PaperPit/DIY-EEG-OpenMind/firmware/selftest/README.md

# Самотест ADS1299

Проверяет собранную плату изнутри: подлинность чипа (ID 0x3E), чтение и запись регистров по SPI, DRDY 250 Гц, напряжение DVDD изнутри (каналы 3 и 4 в режиме MVDD, около 3,3 В), температуру, тестовый сигнал, внутренний шум и путь сигнала через каждый вход. Подробное описание каждой строки вывода и что делать при FAIL в [части 2 инструкции](../../docs/02-tests-3d.html), шаги 6–11.

Это готовый проект PlatformIO. Скачивать репозиторий автора и подменять `main.cpp` не нужно. Библиотека ADS1299 лежит в `lib/ADS1299/` (исходный код Xavier Asghar / Conor Russomanno, GPL v3). В этой копии `RREG` и `WREG` ничего не печатают в монитор порта: у автора каждая запись регистра добавляла строку и забивала результат самотеста.

Прошивка собирается под ESP32-S3-WROOM-1-N16R8: 16 МБ flash и 8 МБ octal PSRAM. На собранной плате она ещё не запускалась, поэтому эталонного лога монитора порта здесь нет. Пример удачного вывода показан в части 2 инструкции.

## Как прошить

1. Установите VS Code и расширение PlatformIO.
2. Откройте папку `firmware/selftest` и дождитесь, пока PlatformIO всё настроит.
3. Подключите плату по USB. SW1 в положение USB. Электроды **не** подключены.
4. Если порт не появился или загрузка не начинается: держите SW3 (BOOT), нажмите и отпустите SW2 (RESET), отпустите SW3.
5. Нажмите Upload. После загрузки нажмите SW2 (RESET).
6. Откройте Serial Monitor, скорость 115200.

Из командной строки, находясь в этой папке: `pio run -t upload` и `pio device monitor`.

## Команды в мониторе порта

- `t` повторить все тесты
- `m` живой монитор: размах сигнала по каналам и биты обрыва электродов

Перед тестом «Input path» соедините все 16 штырьков каналов (1+…8+, 1−…8−) с контактом GND на J3A.

После проверки прошейте рабочую прошивку автора и задайте `BIAS_SENSP` под свои каналы (шаг 12 части 2).
