PaperPit/DIY-EEG-OpenMind/hardware/INPUT-RESISTORS.md

# Входные резисторы R10–R27: шум и безопасность

На плате стоят **2,2 кОм** (0603, тонкая плёнка, 0,1 %), как у автора Low-Cost-EEG. Это выбор на минимальный шум. Ниже расчёт, чтобы каждый мог решить сам, нужен ли ему дополнительный резистор в проводе.

## Что даёт каждый вариант

Тепловой шум резистора равен √(4kTRB). Считаем полосу ЭЭГ 1–40 Гц при 300 K и учитываем два пути: резистор канала и резистор REF.

| Вариант | Шум резисторов, мкВ rms | Ток в электрод при пробое 5 В |
|---|---:|---:|
| 2,2 кОм на плате (по умолчанию) | ≈0,05 | ≈2,3 мА |
| 2,2 кОм на плате + 100 кОм в проводе | ≈0,36 | ≈49 мкА |
| 100 кОм на плате + 100 кОм в проводе | ≈0,5 | ≈25 мкА |

Для сравнения: собственный шум ADS1299 при усилении 24 и 250 Гц около 0,14 мкВ rms по datasheet, шум мокрого электрода на коже обычно 1 мкВ и больше, альфа-ритм 10–50 мкВ.

## Почему 2,2 кОм

- Шум резисторов примерно в 3 раза меньше шума самого АЦП, то есть его практически не видно.
- Ток проверки контакта 24 нА даёт на 2,2 кОм всего около 53 мкВ постоянного смещения, это ничтожно.
- Утечка ESD-диодов D1–D5 и разброс конденсаторов C15–C31 на маленьком сопротивлении почти не превращают сетевые 50 Гц в помеху.

## Чем за это платим

2,2 кОм почти не ограничивает ток. Если внутри платы что-то замкнёт питание ±2,5 В или 3,3 В на вход, через электрод может пойти единицы миллиампер. Для приборов, подключаемых к человеку, норма тока при единичной неисправности около 50 мкА. С одним резистором 2,2 кОм её нет.

Поэтому безопасность в этом варианте держится на питании, а не на резисторе:

1. Электроды на голове только при питании от аккумулятора, плата не подключена к USB компьютера, данные идут по Bluetooth.
2. Если нужен USB во время записи, только через изолятор ADuM3160/ADuM4160.
3. Ни одна цепь платы не должна иметь связи с сетью 220 В, даже через зарядку ноутбука.

Внутри платы только 3,7–5 В, и при питании от LiPo пути на сетевую землю нет.

## Дополнительная защита по желанию

Если хотите уложиться в 50 мкА при неисправности, поставьте резистор 100 кОм 0603 в разрыв каждого провода: К1–К8, REF и BIAS, всего 10 штук. Шум вырастет примерно до 0,36 мкВ rms. Это всё ещё меньше шума контакта, но уже больше шума АЦП. Номинал проводных резисторов должен быть одинаковым во всех 10 проводах.

## Что важно при любом варианте

- C15–C31 только C0G/NP0, лучше с допуском 1–2 %. Разброс ёмкостей вместе с разбросом импедансов электродов превращает синфазные 50 Гц в дифференциальную помеху.
- Все 18 резисторов R10–R27 одного номинала и из одной партии.
- Корпус 0603 и изолятор ADuM не защищают от сети и дефибриллятора. Это не медицинское изделие.
