PaperPit/DIY-EEG-OpenMind/SAFETY.md

# Безопасность

Народное ЭЭГ не является медицинским изделием. Не используйте его для диагностики и лечения.

1. **Электроды на голове только при питании от аккумулятора** или через USB-изолятор (ADuM3160/ADuM4160). Ноутбук, подключённый к сети, во время записи лучше тоже отключить от зарядки. Входные резисторы на плате 2,2 кОм выбраны ради минимального шума и сами ток при неисправности почти не ограничивают (около 2 мА при 5 В). Поэтому питание от аккумулятора здесь обязательно. Для дополнительной защиты можно поставить резистор 100 кОм в каждый провод электрода, включая REF и BIAS: ток при пробое станет около 50 мкА, шум вырастет с 0,05 до 0,36 мкВ rms. Подробно в [hardware/INPUT-RESISTORS.md](hardware/INPUT-RESISTORS.md). Корпус 0603 и изолятор ADuM не защищают от сети и дефибриллятора.
2. **Аккумулятор LiPo только через модуль TP4056 с защитой.** Аккумулятор на выводы B+/B−, плата на OUT+/OUT−. Перепутанная полярность сжигает модуль, а аккумулятор может загореться.
3. **Заряжайте при выключенном тумблере и со снятыми электродами,** не на ткани и не без присмотра. Вздувшийся аккумулятор сразу замените.
4. **Не подключайте к этой плате стимуляторы (tDCS/tACS).** Стимулятор делается отдельным устройством со своим аккумулятором и без общей земли.
5. Клей для оргстекла на дихлорэтане используйте только при открытом окне.
