PaperPit/DIY-EEG-OpenMind/enclosure/case-drawings-1to1.pdf

# Корпус из оргстекла 3 мм · раскрой листа 300 × 200 мм

Все размеры в мм. Внутренний объём 131 × 67 × 38, наружный 137 × 73 × 44.
Сборка: дно (A) снизу, продольные стенки (E, F) во всю длину стоят на дне, торцевые (B, C) вклеиваются между ними.
Крышка (D) кладётся сверху на 4 бобышки из склеенных пар квадратов (G) и крепится саморезами 2,9 × 9,5. Для лазерной резки отдайте файл «Корпус оргстекло 3мм - раскрой.dxf» (слой CUT — резка, слой LABELS — не резать).
Ручная резка: резак для пластика по линейке, 5–8 проходов, затем отломить по краю стола. Отверстия: сверло

### 2 мм, затем

рассверлить до размера на малых оборотах, плёнку не снимать до конца работ. Окна USB: два отверстия 8 мм + надфиль.
Пары деталей с отверстиями (A, D, B, C) распечатайте на следующих страницах в масштабе 100 % и приклейте как шаблон.

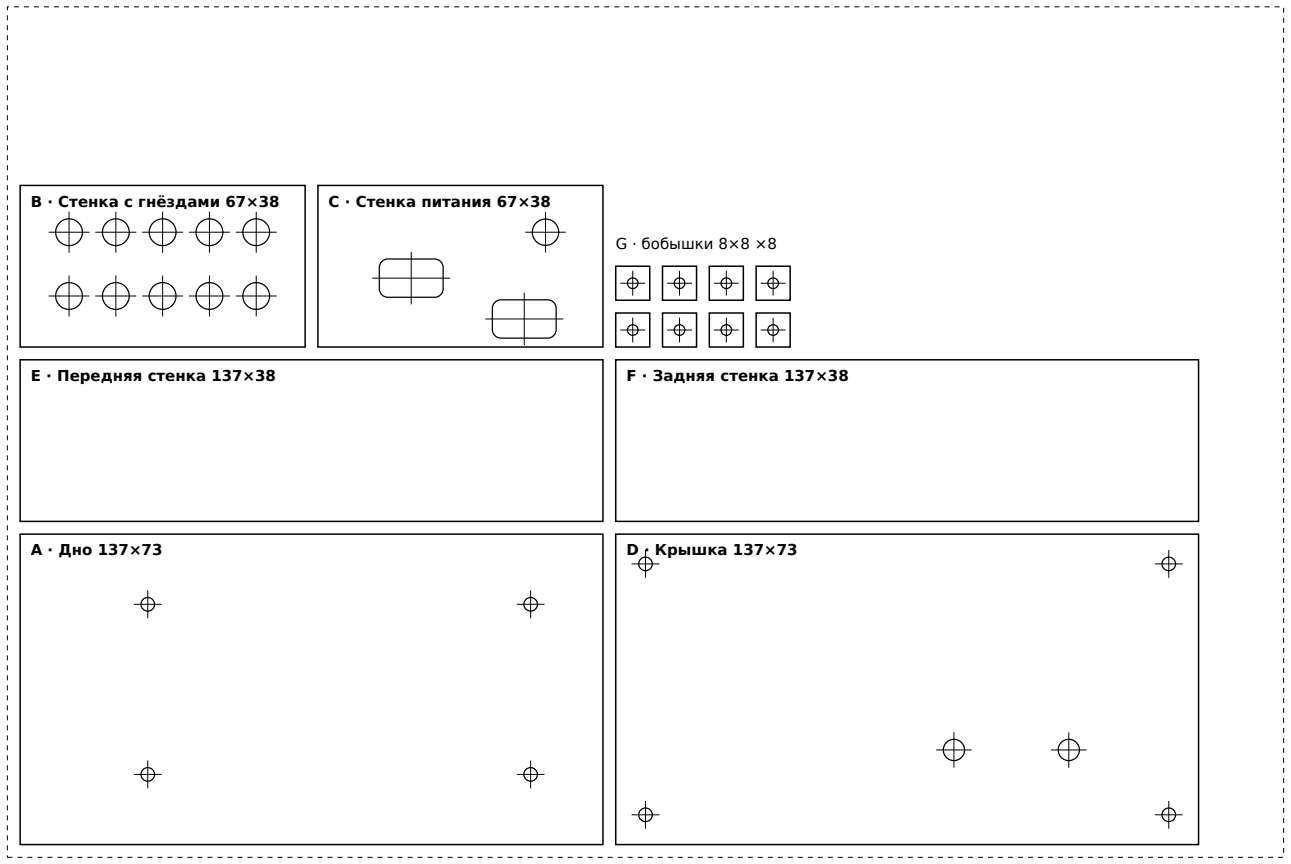
[picture p12: figure]
A · Дно 137×73; · Крышка 137×73; E · Передняя стенка 137×38; F · Задняя стенка 137×38; G · бобышки 8×8 ×8

B · Стенка с гнёздами 67×38 | C · Стенка питания 67×38

Лист 300 × 200 мм, масштаб на этой странице 60 %. Запас между деталями 3 мм на рез.

### Детали

A Дно: 137 × 73
D Крышка: 137 × 73
B Стенка с гнёздами: 67 × 38 C Стенка питания: 67 × 38
E Передняя стенка: 137 × 38 F Задняя стенка: 137 × 38
G Бобышка ×8: 8 × 8 ×8

# Шаблоны 1:1 · дно и крышка (печать 100 %)

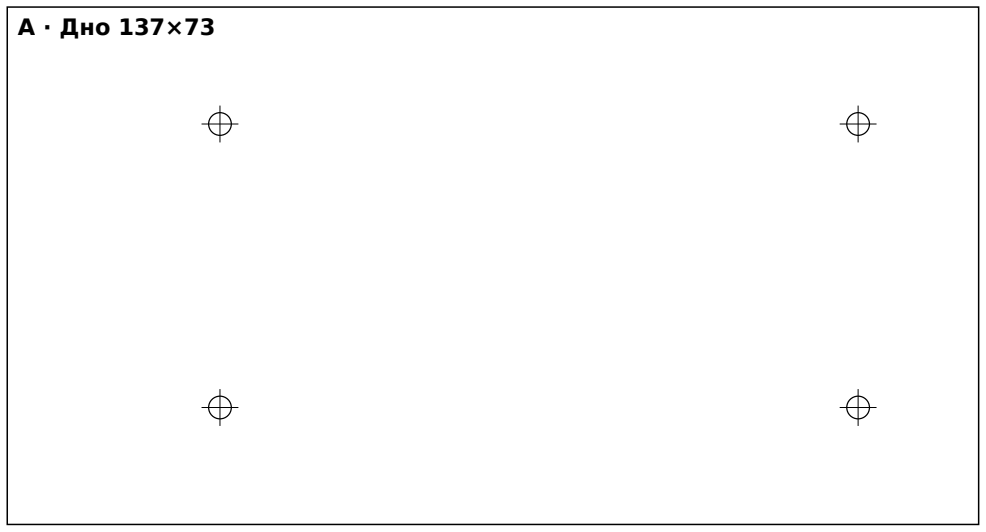
[picture p13: figure]
A · Дно 137×73

Вид сверху. Низ рисунка = передняя стенка (сторона антенны ESP32). 4 отв. Ø3,2 под стойки M3 платы.

Ø3.2 — центр x 30, y 16.5
Ø3.2 — центр x 120, y 16.5
Ø3.2 — центр x 30, y 56.5
Ø3.2 — центр x 120, y 56.5

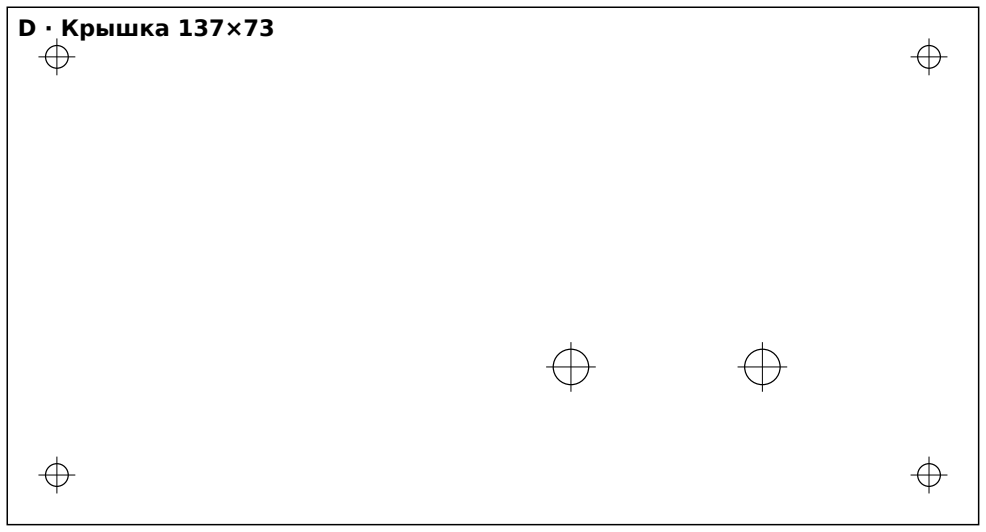
[picture p14: figure]
D · Крышка 137×73

Вид сверху. Углы: Ø3,2 под саморезы в бобышки. Ø5 над кнопками: левое SW3 (BOOT/выход из lead-off), правое SW2 (RESET).

Ø3.2 — центр x 7, y 7
Ø3.2 — центр x 130, y 7
Ø3.2 — центр x 7, y 66
Ø3.2 — центр x 130, y 66
Ø5 — центр x 79.5, y 22.25 Ø5 — центр x 106.5, y 22.25

контроль 50,0 мм — проверьте линейкой

# Шаблоны 1:1 · торцевые стенки, бобышка (печать 100 %)

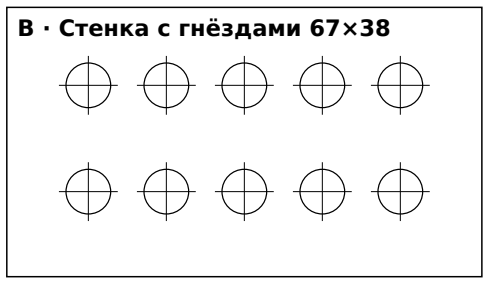
[picture p15: figure]

B · Стенка с гнёздами 67×38 | Вид снаружи. Верхний ряд слева направо: BIAS К7 К5 К3 К1, нижний: К8 К6 К4 К2 REF. Ø6,3 для резьбы M6, уточните по гнезду.
| Ø6.3 — центр x 11.5, y 27 Ø6.3 — центр x 22.5, y 27 Ø6.3 — центр x 33.5, y 27 Ø6.3 — центр x 44.5, y 27 Ø6.3 — центр x 55.5, y 27 Ø6.3 — центр x 11.5, y 12 Ø6.3 — центр x 22.5, y 12 Ø6.3 — центр x 33.5, y 12 Ø6.3 — центр x 44.5, y 12 Ø6.3 — центр x 55.5, y 12

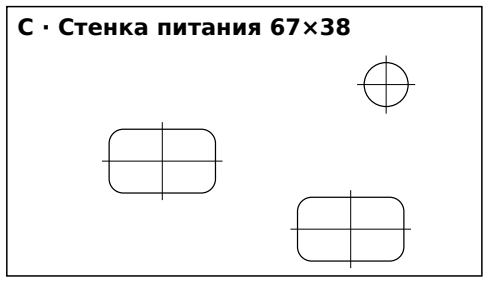
[picture p16: figure]

C · Стенка питания 67×38 | Вид снаружи. Слева вверху окно USB-C платы (данные/прошивка), справа внизу окно USB-C зарядки TP4056, справа вверху Ø6,2 тумблер MTS-102.
| окно 15×9 (R2) — центр x 21.93, y 16.2 окно 15×9 (R2) — центр x 48.5, y 6.6 Ø6.2 — центр x 53.5, y 27

G · Бобышка 8×8, 8 шт.

Склеить попарно (6 мм), 4 штуки в верхние углы под крышку. Отв. Ø2,5 под саморез 2,9.

Ø2.5 — центр x 4, y 4

E и F (137 × 38) без отверстий: просто отрежьте по размеру.

Координаты отверстий: x — от левого края детали, y — от нижнего края, как на рисунке.

контроль 50,0 мм — проверьте линейкой
