PaperPit/DIY-EEG-OpenMind/enclosure/panel-drill-template-1to1.pdf

## Панель электродов Low-Cost-EEG · шаблон сверловки 1:1

Печатать в масштабе 100 % («Фактический размер», без подгонки под страницу).
Проверьте линейкой контрольный отрезок 50,0 мм. Если он не 50 мм, шаблон напечатан неверно.
Перекрестие ЦЕНТР = центр стенки B 67 × 38 мм (корпус из оргстекла). Ряды: 27 и 12 мм от нижнего края стенки. Сверлите сначала 2 мм, затем рассверлите по резьбе EE-B05 (+0,2–0,3 мм к наружному диаметру резьбы).
Вид СНАРУЖИ корпуса. Подписи под отверстиями совпадают с наклейкой на панели.

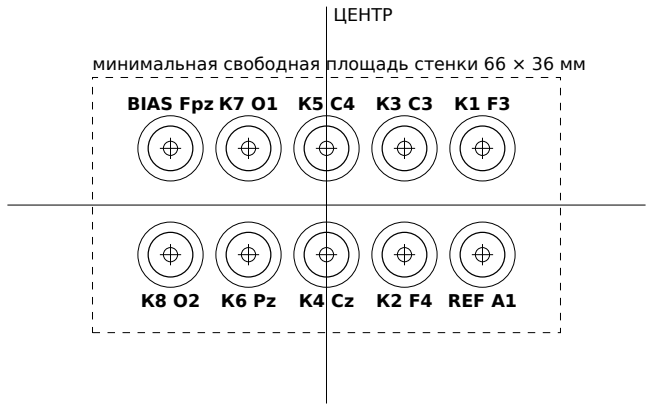
[picture p17: figure]
ЦЕНТР; BIAS Fpz; REF A1

минимальная свободная площадь стенки 66 × 36 мм

Шаг по горизонтали 11,0 мм, между рядами 15,0 мм.
Внутренний круг Ø6,3 мм: отверстие под M6 (уточнить по замеру). Внешний круг Ø9,2 мм: гайка.

контроль 50,0 мм

Разводка (внутри корпуса), провод Dupont на ВЫВОД 1 (внешний ряд, квадратная площадка):

К1→J3I К2→J3H К3→J3G К4→J3F К5→J3E К6→J3D К7→J3C К8→J3B REF→J3J BIAS→J3A

Вывод 2 у J3A = GND (только экран), у J3J = SRB2 (не подключать), у остальных = минус канала (свободен).
