PaperPit/DIY-EEG-OpenMind/docs/img/device-electrodes.jpg

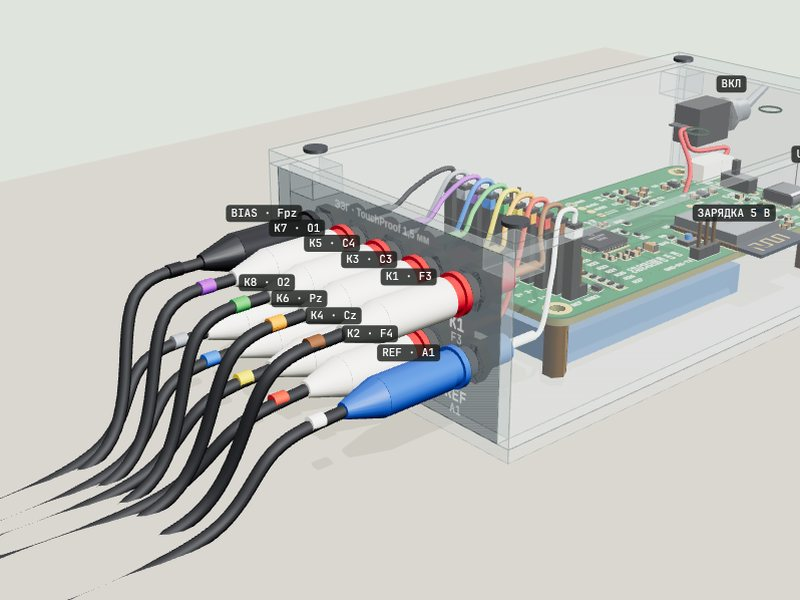
docs/img/device-electrodes.jpg
