PaperPit/DIY-EEG-OpenMind/docs/img/social-preview.jpg

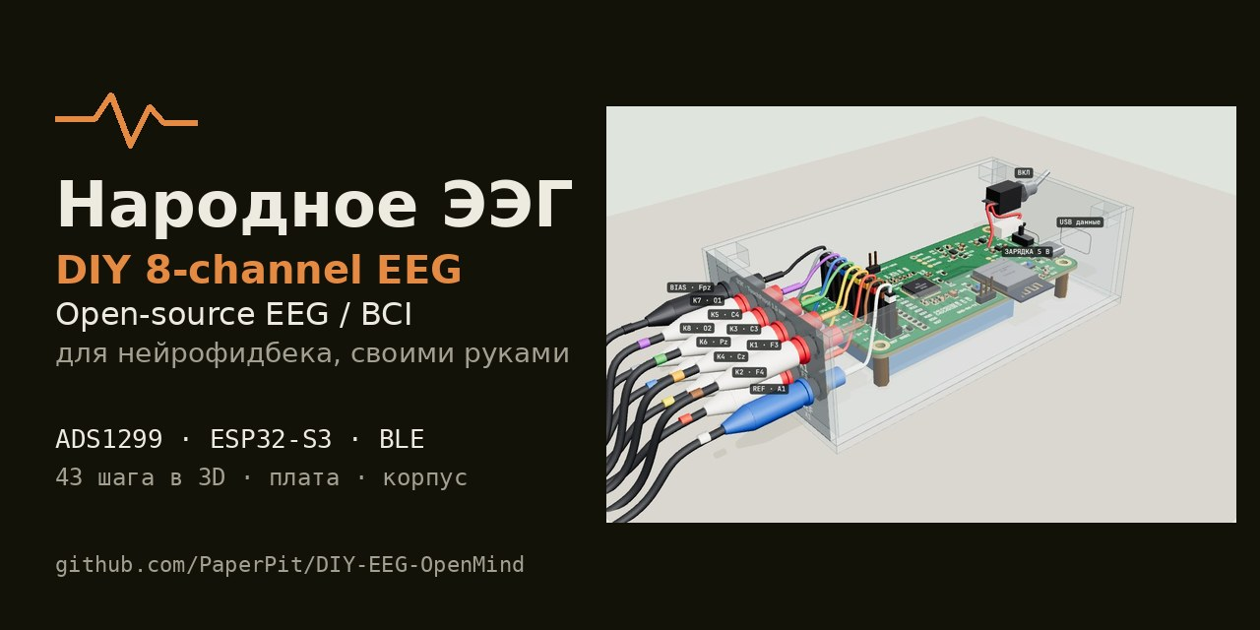
docs/img/social-preview.jpg
