PaperPit/DIY-EEG-OpenMind/hardware/bom.csv

Designator | Qty | Значение | Корпус | Исходный MPN (Mouser) | Что заказать на LCSC | LCSC # | Примечание
U4 | 1 | ADS1299, 8 каналов, 24 бит | TQFP-64 (0,5 мм) | ADS1299IPAGR | ADS1299IPAGR (TI) | C476817 | Главная деталь, ~$62. Брать только у LCSC/Mouser/Чип и Дип, не на AliExpress (риск подделки)
U5 | 1 | Модуль ESP32-S3, 8 МБ flash, 8 МБ PSRAM | WROOM-1 | ESP32-S3-WROOM-1-N8R8 | ESP32-S3-WROOM-1-N16R8 (Espressif) | C2913202 | N8R8 на LCSC нет в наличии (C2913201). N16R8 той же посадки, прошивки автора и Da1412 работают на нём без изменений
U1 | 1 | Charge pump + LDO, ±2,5 В для AVDD/AVSS | WSON-12 | LM27762DSSR | LM27762DSSR (TI) | C473398 | $0,97, в наличии
U2 | 1 | LDO 3,3 В 1 А (ESP32) | SOT-23-5 | TLV75733PDBVR | TLV75733PDBVR (TI) | C485517
U3 | 1 | LDO 3,3 В 300 мА малошумящий (DVDD ADS1299) | SOT-23-5 | TPS7A2033PDBVR | TPS7A2033PDBVR (TI) | C2862740
D1–D5 | 5 | ESD-защита 4 линии, 0,7 пФ | SC-70-6 | TPD4E1B06DCKR | TPD4E1B06DCKR (TI) | C840093 | Защита входов электродов. Не заменять на диоды с большой утечкой
D6 | 1 | TVS 5 В | SOD-323 | SD05T1G | SD05T1G (onsemi) | C233423 | Защита USB
D7 | 1 | TVS 5 В | SOD-523 | ESD5Z5.0T5G | ESD5Z5.0T1G (onsemi) | C82044 | Защита входа батареи
J1 | 1 | JST PH 2 пин, угловой, THT | — | S2B-PH-K-S | S2B-PH-K-S(LF)(SN) или клон | искать по MPN | Разъём аккумулятора. Проверить полярность провода LiPo!
J2 | 1 | USB-C 2.0 гнездо | SMD | 217179-0001 | 217179-0001 (Molex) | C3197684
J3A–J3J, JP1 | 11 | Штырьки 2×1, шаг 2,54 | THT | TSW-102-26-F-S | Любая PLS гребёнка 2,54 мм (отломать) | — | Входы электродов. Удобно взять 40-пин гребёнку
J5 | 1 | Штырьки 3×1, шаг 2,54 | THT | TSW-103-07-T-S | Любая PLS гребёнка 2,54 мм | — | UART
SW1 | 1 | Ползунковый переключатель SPDT | THT | 1101M2S3CQE2 | 1101M2S3CQE2 (C&K) или совместимый по посадке | искать по MPN | Сверить шаг выводов по чертежу перед заменой
SW2, SW3 | 2 | Тактовая кнопка | SMD | 7914J-1-032 | 7914J-1-032 (Bourns) | искать по MPN | BOOT и RESET
TP1 | 1 | Тестовая точка | THT | Keystone 5003 | Keystone 5003 или пропустить | — | Можно не ставить
R10–R27 | 18 | 2,2 кОм 0,1% тонкоплёночный | 0603 | MCT06030D2201BP500 | 2,2 кОм 0603 0,1% (или 1%) | — | 18 штук, как у автора (в описании его BOM ошибочно «100 Ом», по MPN это 2,2 кОм). Минимальный шум, около 0,05 мкВ rms. Резистор 100 кОм в проводе по желанию, см. hardware/INPUT-RESISTORS.md
R1 | 1 | 130 кОм | 0603 | MCT06030D1303BP100 | 130 кОм 0603 1% | — | ВНИМАНИЕ: в описании BOM ошибочно «100 Ом», по MPN и схеме 130 кОм
R9 | 1 | 1 МОм | 0603 | MCT06030C1004FPW00 | 1 МОм 0603 1% | — | ВНИМАНИЕ: в описании BOM ошибочно «100 Ом», по MPN и схеме 1 МОм (цепь BIAS)
R2 | 1 | 120 кОм 0,1% | 0603 | RT0603BRD07120KL | 120 кОм 0603 0,1% | — | Задаёт напряжение LM27762. Точность важна
R3 | 1 | 105 кОм 0,1% | 0603 | RT0603BRD07105KL | 105 кОм 0603 0,1% | — | Задаёт напряжение LM27762. Точность важна
R4 | 1 | 100 кОм 0,1% | 0603 | AT0603BRD07100KL | 100 кОм 0603 0,1% | — | Задаёт напряжение LM27762. Точность важна
R5, R6 | 2 | 5,1 кОм 1% | 0603 | RT0603FRE075K1L | 5,1 кОм 0603 | — | CC-резисторы USB-C
R7, R8, R28–R35 | 10 | 10 кОм 1% | 0603 | AC0603FR-7W10KL | 10 кОм 0603 | —
C15–C31 | 17 | 1 нФ C0G/NP0 1% | 0603 | C0603C102F5GACTU | 1 нФ 0603 C0G (NP0) | — | Входные фильтры. Обязательно C0G/NP0, не X7R
C14 | 1 | 1,5 нФ C0G 100 В | 0603 | GRM1885C2A152JA01D | 1,5 нФ 0603 C0G | — | Цепь BIAS
C1 | 1 | 0,47 мкФ X7R 16 В | 0603 | C0603C474K4RACAUTO | 0,47 мкФ 0603 X7R | —
C10, C11, C35, C36, C38–C40, C43, C44, C46 | 10 | 1 мкФ X7R 16 В | 0603 | CC0603KRX7R7BB105 | 1 мкФ 0603 X7R | —
C13 | 1 | 100 нФ X7R 50 В | 0603 | CGA3E2X7R1H104K080AD | 100 нФ 0603 X7R | —
C32, C37, C41, C42, C45, C47 | 6 | 100 нФ X7R | 0603 | C0603X104J4RACTU | 100 нФ 0603 X7R | —
C2, C3, C48, C49 | 4 | 4,7 мкФ X7R 16 В | 0805 | GCJ21BR71C475KA01K | 4,7 мкФ 0805 X7R | —
C4, C5 | 2 | 2,2 мкФ X7R 16 В | 0805 | GCM21BR71C225KA64K | 2,2 мкФ 0805 X7R | — | Летающие конденсаторы LM27762
C6, C7, C9, C12, C33 | 5 | 10 мкФ X5R 25 В | 0805 | GRJ21BR61E106KE01L | 10 мкФ 0805 X5R 25 В | —
C34 | 1 | 100 мкФ X5R 10 В | 1206 | GRM31CR61A107MEA8L | 100 мкФ 1206 X5R | —
— | 1 | Аккумулятор LiPo 3,7 В 2000 мА·ч с защитой и разъёмом JST PH 2.0 | — | — | AliExpress / Чип и Дип | — | Не входит в BOM автора
— | 1 | Модуль зарядки TP4056 (USB-C) с защитой | — | — | AliExpress / Чип и Дип | — | На плате нет зарядки
