PaperPit/DIY-EEG-OpenMind/hardware/shopping-list.csv

Магазин | Что купить | Корпус | Кол-во купить | Нужно на 1 плату | Ссылка или запрос для поиска | Ориентир цены за всё, ₽ | Примечание
AliExpress (продавец с отзывами) | ADS1299IPAG или ADS1299IPAGR (TI) | TQFP-64 | 1 | 1 | https://aliexpress.ru/wholesale?SearchText=ADS1299IPAG | 3 300–5 300 | Главная деталь. Цены на AliExpress $39–62. Брать у продавца с рейтингом 97%+ и отзывами с фото. После пайки проверить: регистр ID = 0x3E. Бывают подделки и перемаркировка
Чип и Дип (запасной вариант) | ADS1299IPAGR (TI) | TQFP-64 | — | — | https://www.chipdip.ru/product0/8029976658 | 11 080 за шт. | Минимальная партия у них была 6 шт (≈66 тыс ₽). Позвонить или написать менеджеру: иногда продают 1 шт под заказ
Чип и Дип | ESP32-S3-WROOM-1-N16R8 (Espressif) | модуль | 1 | 1 | https://www.chipdip.ru/product/esp32-s3-wroom-1-n16r8-vstraivaemyy-wi-fi-ble5.0-espressif-9001095134 | 700–1 000 | Именно WROOM-1 (антенна на плате), не WROOM-1U. Подходит и N8R8. На AliExpress: https://aliexpress.ru/wholesale?SearchText=ESP32-S3-WROOM-1-N16R8
AliExpress | LM27762DSSR (TI) | WSON-12 | 3 | 1 | https://aliexpress.ru/wholesale?SearchText=LM27762DSSR | 500–800 | Пример лота 5 шт: https://www.aliexpress.us/item/3256807318608101.html. В Чип и Дип тоже есть: https://www.chipdip.ru/product1/8017626869. Замены нет, корпус уникальный
AliExpress | TPS7A2033PDBVR (TI), стабилизатор 3,3 В малошумящий | SOT-23-5 | 5 | 1 | https://aliexpress.ru/wholesale?SearchText=TPS7A2033PDBVR | 300–600 | Если не найдётся: TLV75733PDBVR, у него та же цоколёвка (1 IN, 2 GND, 3 EN, 4 NC, 5 OUT), шум чуть выше. Также искать в Чип и Дип: https://www.chipdip.ru/search?searchtext=TPS7A2033
AliExpress | TLV75733PDBVR (TI), стабилизатор 3,3 В | SOT-23-5 | 10 | 1 | https://aliexpress.ru/wholesale?SearchText=TLV75733PDBVR | 100–150 | Лоты по 10 шт от $1,09. Маркировка на корпусе 1FKF. Не путать с TLV75533 и TLV75733PDRVR (другой корпус)
AliExpress | TPD4E1B06DCKR (TI), защита входов | SC-70-6 (SOT-363) | 10 | 5 | https://aliexpress.ru/wholesale?SearchText=TPD4E1B06DCKR | 300–500 | Лоты по 10 шт $3,7–5,5. Маркировка BY/BYP. Не путать с TPD4E1U06 (BP*), у него другая ёмкость
AliExpress или Чип и Дип | SD05T1G (onsemi) или любой TVS 5 В | SOD-323 | 5 | 1 | https://aliexpress.ru/wholesale?SearchText=SD05T1G%20SOD-323 | 100–200 | Аналог: любой однонаправленный TVS 5 В в SOD-323. Чип и Дип: https://www.chipdip.ru/search?searchtext=SD05%20SOD-323
AliExpress или Чип и Дип | ESD5Z5.0T1G (onsemi) или аналог | SOD-523 | 5 | 1 | https://aliexpress.ru/wholesale?SearchText=ESD5Z5.0T1G | 100–200 | Аналог: любой ESD-диод 5 В в SOD-523. Чип и Дип: https://www.chipdip.ru/search?searchtext=ESD5Z5.0
Чип и Дип или AliExpress | USB-C гнездо Molex 217179-0001, 16 контактов | SMD + выводы корпуса | 2 | 1 | https://www.chipdip.ru/search?searchtext=217179-0001 ; https://aliexpress.ru/wholesale?SearchText=217179-0001%20USB%20C | 200–600 | Замена: HRO TYPE-C-31-M-12 (верхний монтаж, 16 контактов, 4 вывода корпуса в пазы ~8,6 мм поперёк, ~4 мм вдоль). Врезные (mid-mount) с плоскими лапками НЕ подходят
Чип и Дип или AliExpress | Гнездо JST PH 2 контакта, угловое, S2B-PH-K-S | THT, шаг 2,0 | 2 | 1 | https://www.chipdip.ru/product1/8002985838 | 30–60 | Разъём аккумулятора. На AliExpress «PH2.0 2P угловой» тоже подходит
Чип и Дип или AliExpress | Ползунковый переключатель C&K 1101M2S3CQE2 | THT | 1 | 1 | https://www.chipdip.ru/search?searchtext=1101M2S3CQE2 ; https://aliexpress.ru/wholesale?SearchText=1101M2S3CQE2 | 300–500 | Выключатель питания. Проверенная замена: SS12D10 (G4/G5) с шагом выводов 4,7 мм. На плате 3 отверстия 1,85 мм, шаг 4,7 мм
Чип и Дип или AliExpress | Кнопка Bourns 7914J-1-032 (или 7914J-1-032E) | SMD | 3 | 2 | https://www.chipdip.ru/product0/8007351713 | 150–300 | Аналог: тактовая SMD-кнопка того же размера, сверить по площадкам
AliExpress или Чип и Дип | Штыревая гребёнка PLS 1×40, шаг 2,54 | THT | 2 | — | https://aliexpress.ru/wholesale?SearchText=pin%20header%201x40%202.54 | 50 | Нарезать на 11 штук по 2 и 1 по 3
AliExpress | Набор резисторов 0603 1%, 170 номиналов по 20–50 шт | 0603 | 1 | — | https://aliexpress.ru/wholesale?SearchText=0603%20resistor%20kit%201%25%20170%20values | 400–700 | Закрывает 130 кОм (R1), 1 МОм (R9), 5,1 кОм (R5, R6), 10 кОм (R7, R8, R28–R35)
Чип и Дип | Резистор 2,2 кОм 0,1% 0603 (тонкоплёночный) | 0603 | 20 | 18 | https://www.chipdip.ru/search?searchtext=0603%200.1%25%202.2%20%D0%BA%D0%9E%D0%BC | 300–600 | R10–R27, входные фильтры. 0,1% даёт лучшее совпадение каналов и меньше наводки 50 Гц
Чип и Дип | Резистор 100 кОм 0603 (по желанию, в провода) | 0603 | 12 | 0 | https://www.chipdip.ru/search?searchtext=0603%200.1%25%20100%20%D0%BA%D0%9E%D0%BC | 100–300 | Не обязательно. 10 штук в провода К1–К8, REF и BIAS для защиты: ток при пробое 50 мкА, шум 0,36 мкВ rms. См. hardware/INPUT-RESISTORS.md
Чип и Дип | Резистор 120 кОм 0,1% 0603 (тонкоплёночный) | 0603 | 5 | 1 | https://www.chipdip.ru/search?searchtext=0603%200.1%25%20120%20%D0%BA%D0%9E%D0%BC | 100–200 | R2. Точность 0,1% обязательна
Чип и Дип | Резистор 105 кОм 0,1% 0603 (тонкоплёночный) | 0603 | 5 | 1 | https://www.chipdip.ru/search?searchtext=0603%200.1%25%20105%20%D0%BA%D0%9E%D0%BC | 100–200 | R3. Точность 0,1% обязательна, в наборах такого номинала нет
Чип и Дип | Резистор 100 кОм 0,1% 0603 (тонкоплёночный) | 0603 | 5 | 1 | https://www.chipdip.ru/search?searchtext=0603%200.1%25%20100%20%D0%BA%D0%9E%D0%BC | 100–200 | R4. Точность 0,1% обязательна
Чип и Дип | Конденсатор 1 нФ C0G (NP0) 50 В 0603 | 0603 | 20 | 17 | https://www.chipdip.ru/search?searchtext=1%20%D0%BD%D0%A4%200603%20NP0 | 100–200 | C15–C31. Строго C0G/NP0, допуск 1–2% (буква F или G в маркировке). Из наборов AliExpress не брать: диэлектрик не гарантирован
Чип и Дип | Конденсатор 1,5 нФ C0G (NP0) 0603 | 0603 | 5 | 1 | https://www.chipdip.ru/search?searchtext=1.5%20%D0%BD%D0%A4%200603%20NP0 | 50 | C14. Строго C0G/NP0
AliExpress или Чип и Дип | Конденсатор 100 нФ X7R 50 В 0603 | 0603 | 20 | 7 | https://aliexpress.ru/wholesale?SearchText=0603%20100nF%20X7R%2050V | 50–100 | C13, C32, C37, C41, C42, C45, C47
AliExpress или Чип и Дип | Конденсатор 1 мкФ X7R 16 В 0603 | 0603 | 20 | 10 | https://aliexpress.ru/wholesale?SearchText=0603%201uF%20X7R%2016V | 50–100
AliExpress или Чип и Дип | Конденсатор 0,47 мкФ X7R 16 В 0603 | 0603 | 10 | 1 | https://aliexpress.ru/wholesale?SearchText=0603%20474%20X7R | 50 | C1
Чип и Дип | Конденсатор 2,2 мкФ X7R 16 В 0805 | 0805 | 5 | 2 | https://www.chipdip.ru/search?searchtext=2.2%20%D0%BC%D0%BA%D0%A4%200805%20X7R%2016%20%D0%92 | 50–100 | C4, C5 у LM27762
Чип и Дип | Конденсатор 4,7 мкФ X7R 16 В 0805 | 0805 | 10 | 4 | https://www.chipdip.ru/search?searchtext=4.7%20%D0%BC%D0%BA%D0%A4%200805%20X7R%2016%20%D0%92 | 100
Чип и Дип | Конденсатор 10 мкФ 25 В 0805 (X5R или X7R) | 0805 | 10 | 5 | https://www.chipdip.ru/search?searchtext=10%20%D0%BC%D0%BA%D0%A4%200805%2025%20%D0%92 | 100–150
Чип и Дип | Конденсатор 100 мкФ 10 В 1206 (X5R) | 1206 | 2 | 1 | https://www.chipdip.ru/search?searchtext=100%20%D0%BC%D0%BA%D0%A4%201206%2010%20%D0%92 | 100–200 | C34
AliExpress | USB-изолятор на ADuM3160 (USB 2.0 Full Speed) | модуль | 1 | — | https://aliexpress.ru/wholesale?SearchText=ADuM3160%20USB%20isolator | 1 000–1 500 | Для работы по USB при электродах на голове: развязывает человека от компьютера и сети
Ozon или AliExpress | Аккумулятор LiPo 3,7 В 2000 мА·ч с платой защиты и разъёмом JST PH 2.0 | — | 1 | 1 | https://www.ozon.ru/search/ | 500–800 | Перед подключением проверить полярность: красный провод на + у J1
Ozon или AliExpress | Модуль зарядки TP4056 USB-C с защитой | — | 2 | 1 | https://www.ozon.ru/search/ | 150–250 | Заряжать отдельно, на плате зарядки нет
AliExpress или Ozon | Золочёные чашечные ЭЭГ-электроды, набор 10 шт | — | 1 | 1 | https://aliexpress.ru/wholesale?SearchText=EEG%20gold%20cup%20electrode | 1 500–2 500 | 8 каналов + REF + BIAS
AliExpress | Ушные клипсы-электроды | — | 2 | 2 | https://aliexpress.ru/wholesale?SearchText=EEG%20ear%20clip%20electrode | 300–500 | Референс и BIAS на мочки ушей
Ozon или AliExpress | Перемычки Dupont мама–мама 20 см | — | 1 | 1 | https://www.ozon.ru/search/ | 150–250 | Подключение электродов к гребёнкам
Ozon или AliExpress | Электропроводная паста для ЭЭГ (Ten20 или аналог) | — | 1 | 1 | https://www.ozon.ru/search/ | 800–1 500
Ozon или AliExpress | Эластичная шапочка или повязка для электродов | — | 1 | 1 | https://aliexpress.ru/wholesale?SearchText=EEG%20cap%20headband%20electrode | 500–1 000
Ozon или Чип и Дип | Гелевый флюс RMA-223 или аналог | — | 1 | — | https://www.ozon.ru/search/?text=%D1%84%D0%BB%D1%8E%D1%81%20RMA-223 | 300 | Инструмент, если нет
Ozon или Чип и Дип | Паяльная паста Sn63/Pb37 | — | 1 | — | https://www.ozon.ru/search/ | 400 | Инструмент, если нет
Ozon | Оплётка 2–3 мм, изопропиловый спирт, пинцет | — | 1 | — | https://www.ozon.ru/search/ | 500 | Инструмент, если нет
AliExpress или Ozon | Учебный набор SMD или переходники TQFP64/QFN→DIP | — | 1 | — | https://aliexpress.ru/wholesale?SearchText=TQFP64%20adapter%20board | 250 | Тренировка перед основной платой
