PaperPit/DIY-EEG-OpenMind/enclosure/shopping-list-panel.csv

Магазин | Что купить | Кол-во купить | Нужно | Ссылка или запрос для поиска | Ориентир цены, ₽ | Примечание
Ozon | Оргстекло прозрачное 3 мм, лист не меньше 300 × 200 мм | 1 | 1 | https://www.ozon.ru/search/ | 300–600 | Литое или экструзионное, оба подходят. Либо сразу отдать DXF в мастерскую лазерной резки (обычно 300–800 ₽ за такой лист вместе с материалом)
Ozon / Чип и Дип | Клей для оргстекла (на основе дихлорэтана) со шприцем или иглой | 1 | 1 | https://www.ozon.ru/search/ | 200–400 | Капиллярный: наносится в стык, затекает сам. Клеить при открытом окне
Ozon | Резак для пластика (крючковый нож) | 1 | 1 | https://www.ozon.ru/search/ | 200–400 | Не нужен при лазерной резке
Ozon / Чип и Дип | Саморезы 2,9 × 9,5 с полукруглой головкой | 4 | 4 | https://www.ozon.ru/search/?text=%D1%81%D0%B0%D0%BC%D0%BE%D1%80%D0%B5%D0%B7+2.9x9.5 | 50–100 | Крышка к бобышкам. Можно M3 × 8, если нарезать резьбу метчиком
Чип и Дип | Тумблер MTS-102 (ON-ON, 3 вывода, отв. 6 мм) | 1 | 1 | https://www.chipdip.ru/search?searchtext=MTS-102 | 60–120 | Выключатель питания на стенке C. Используются средний и один крайний вывод
Чип и Дип / AliExpress | Пигтейлы JST PH 2.0, 2 контакта (вилка и розетка на проводах) | 2 пары | 2 | https://aliexpress.ru/wholesale?SearchText=JST%20PH%202.0%202pin%20pigtail%20male%20female | 100–200 | Один под разъём аккумулятора к B+/B−, второй из OUT к J1 платы. Полярность J1: квадратная площадка = минус
Чип и Дип | Провод монтажный силиконовый 22–24 AWG, красный и чёрный | по 0,5 м | ≈ 30 см | https://www.chipdip.ru/search | 60–150 | Питание: TP4056 → тумблер → J1
— | Модуль TP4056 USB-C с защитой и LiPo 2000 мА·ч с JST PH | — | 1 + 1 | — | — | Уже есть в основном списке покупок. Брать модуль именно с защитой: шесть площадок IN, B+, B−, OUT+, OUT−
Ozon / AliExpress | Ножки резиновые самоклеящиеся | 4 | 4 | https://www.ozon.ru/search/ | 50–150 | Чтобы головки винтов на дне не царапали стол
AliExpress | Гнёзда EE-B05 под DIN 42802 1,5 мм (TouchProof), под гайку | 2 лота по 8 шт | 10 | https://aliexpress.ru/wholesale?SearchText=EE-B05%20DIN42802%201.5mm%20socket | 700–1 400 | Тот лот со скриншота. Если можно выбрать цвет: 8 красных + 1 синее (REF) + 1 чёрное (BIAS). Запас на случай сорванной резьбы
Чип и Дип / AliExpress | Провода Dupont «мама–мама» 10 см, шлейф 40 шт | 1 | 10 | https://www.chipdip.ru/search | 100–200 | Стандартный радужный шлейф уже идёт по цветовому коду 1 коричневый … 8 серый, 9 белый, 10 чёрный. Резать пополам, разъём остаётся на одном конце
Ozon / AliExpress | Стойки M3 латунные «мама–мама» 12 мм + винты M3×6 | 4 стойки, 8 винтов | 4 | https://www.ozon.ru/search/ | 200–400 | Плата крепится за 4 отверстия Ø3,2 по углам к дну. Снизу винты M3×6, сверху M3×6 через плату. 12 мм оставляют место под аккумулятор
Чип и Дип / Ozon | Термоусадка 2–3 мм, набор цветов | 1 набор | 10 кусочков | https://www.ozon.ru/search/ | 100–200 | На пайку к хвостовику гнезда
Ozon / AliExpress | Медная лента с токопроводящим клеем, 25–50 мм | 1 рулон 5 м | ≈ 1,5 м | https://www.ozon.ru/search/ | 300–600 | По желанию (шаг 6). Именно с токопроводящим клеем, иначе полосы между собой не соединятся
Ozon / AliExpress | Маркеры для кабелей (кольца с цифрами 0–9) | 1 набор | 20 | https://www.ozon.ru/search/ | 150–300 | На кабели электродов MCScap, по номеру гнезда
Ozon / Чип и Дип | Самоклеящаяся плёнка или бумага для принтера + прозрачный скотч | 1 | 1 лист | https://www.ozon.ru/search/ | 100–300 | Наклейка с подписями гнёзд. Можно просто бумагу под скотч
Ozon / AliExpress | Ступенчатое сверло 4–12 мм (если нет) | 1 | 1 | https://www.ozon.ru/search/ | 200–400 | Ровные отверстия в пластике без сколов
— | Гнёзда V-LOCK угловые | не покупать | 0 | — | — | Нужны только для варианта Б с отдельной платой. Если уже куплены, пришлите замеры, я нарисую плату
