PaperPit/DIY-EEG-OpenMind/enclosure/case-acrylic-3mm-cut.dxf

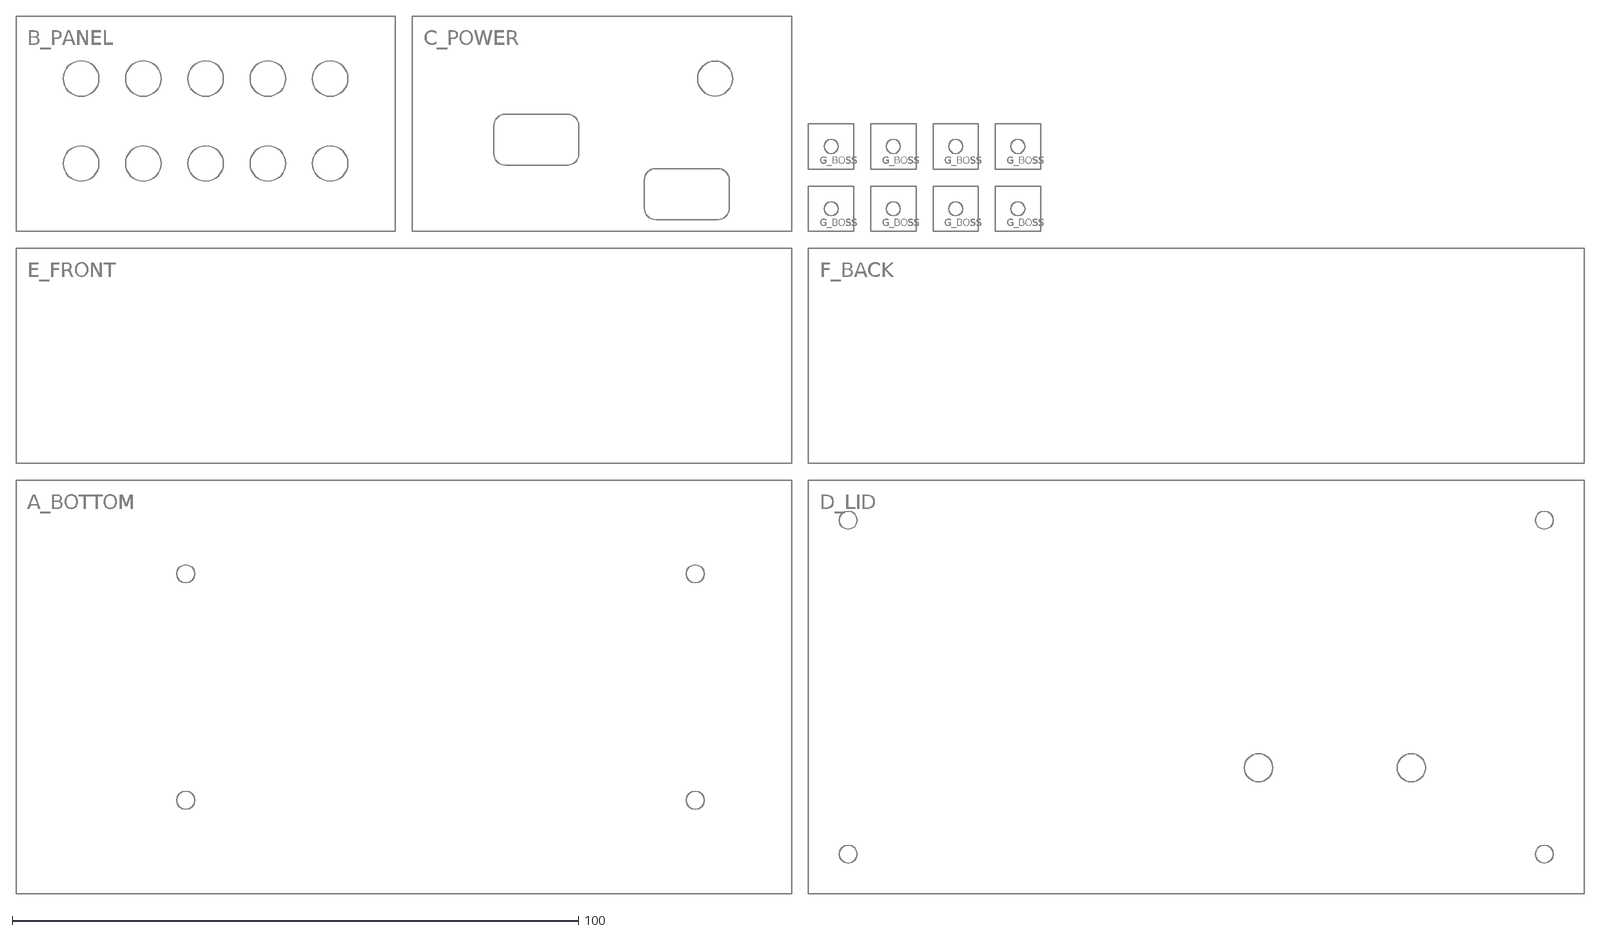
[picture p20: CAD file, 2026-10-26]
enclosure/case-acrylic-3mm-cut.dxf
A_BOTTOM
D_LID
B_PANEL
C_POWER
E_FRONT
F_BACK
G_BOSS
