PaperPit/DIY-EEG-OpenMind/docs/img/steps/a02.jpg

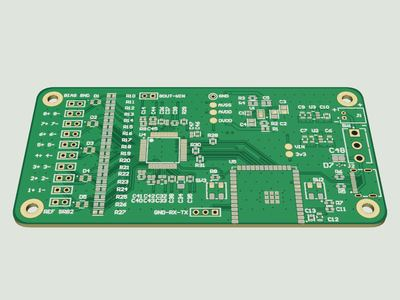
docs/img/steps/a02.jpg
