PaperPit/DIY-EEG-OpenMind/docs/img/steps/a04.jpg

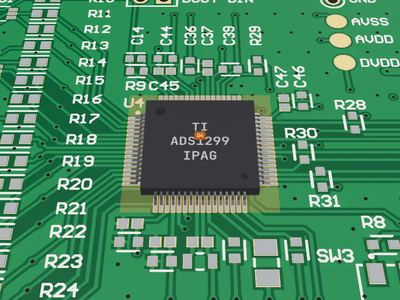
docs/img/steps/a04.jpg
