PaperPit/DIY-EEG-OpenMind/docs/img/steps/a05.jpg

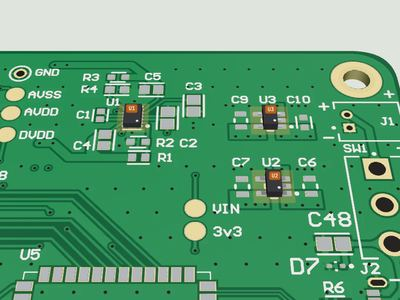
docs/img/steps/a05.jpg
