PaperPit/DIY-EEG-OpenMind/docs/img/steps/a06.jpg

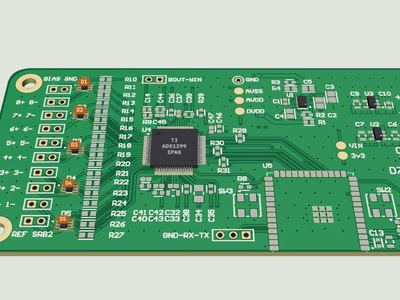
docs/img/steps/a06.jpg
