PaperPit/DIY-EEG-OpenMind/docs/img/steps/a07.jpg

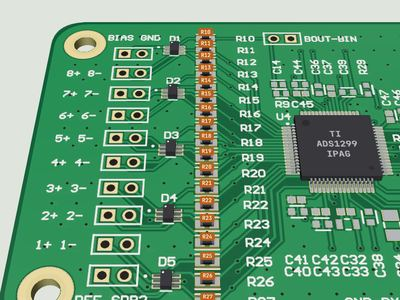
docs/img/steps/a07.jpg
