PaperPit/DIY-EEG-OpenMind/docs/img/steps/a08.jpg

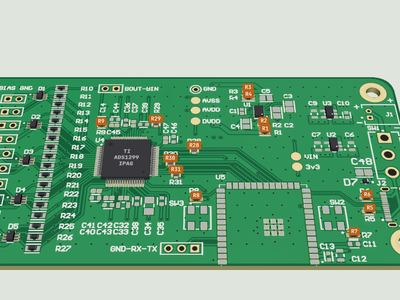
docs/img/steps/a08.jpg
