PaperPit/DIY-EEG-OpenMind/docs/img/steps/a09.jpg

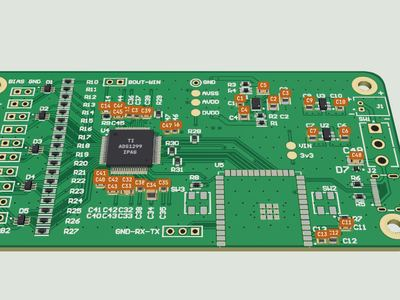
docs/img/steps/a09.jpg
