PaperPit/DIY-EEG-OpenMind/docs/img/steps/a10.jpg

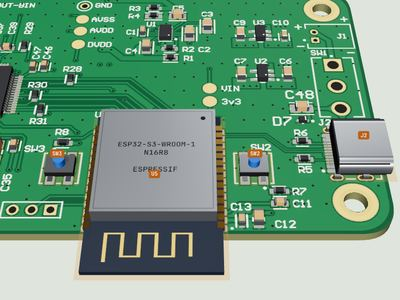
docs/img/steps/a10.jpg
