PaperPit/DIY-EEG-OpenMind/docs/img/steps/a12.jpg

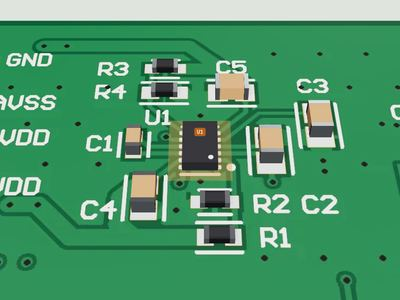
docs/img/steps/a12.jpg
