PaperPit/DIY-EEG-OpenMind/docs/img/steps/a13.jpg

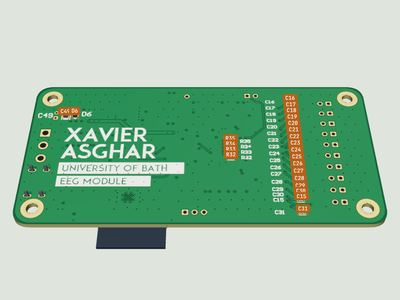
docs/img/steps/a13.jpg
