PaperPit/DIY-EEG-OpenMind/docs/img/steps/a14.jpg

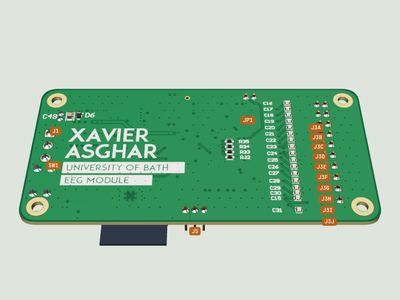
docs/img/steps/a14.jpg
