PaperPit/DIY-EEG-OpenMind/docs/img/steps/a15.jpg

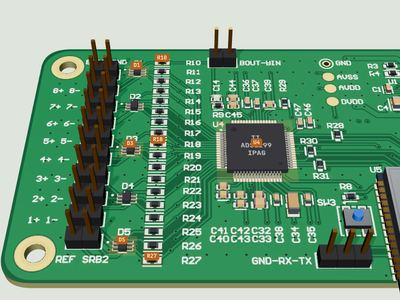
docs/img/steps/a15.jpg
