PaperPit/DIY-EEG-OpenMind/docs/img/steps/a16.jpg

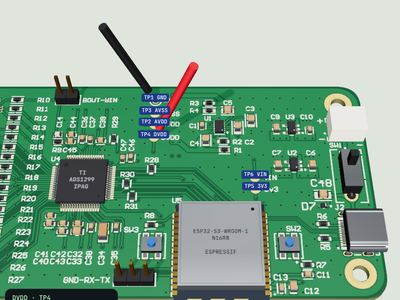
docs/img/steps/a16.jpg
