PaperPit/DIY-EEG-OpenMind/docs/img/steps/p01.jpg

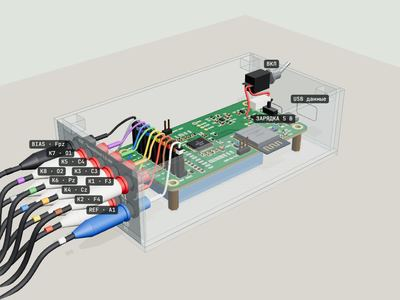
docs/img/steps/p01.jpg
