PaperPit/DIY-EEG-OpenMind/docs/img/steps/p02.jpg

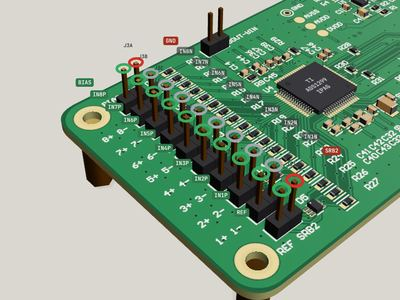
docs/img/steps/p02.jpg
