PaperPit/DIY-EEG-OpenMind/docs/img/steps/p05.jpg

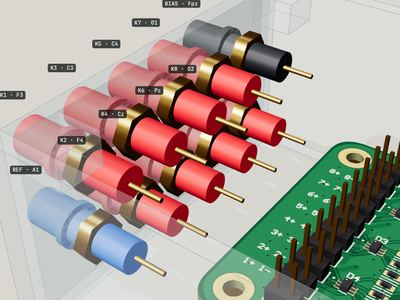
docs/img/steps/p05.jpg
