PaperPit/DIY-EEG-OpenMind/docs/img/steps/p07.jpg

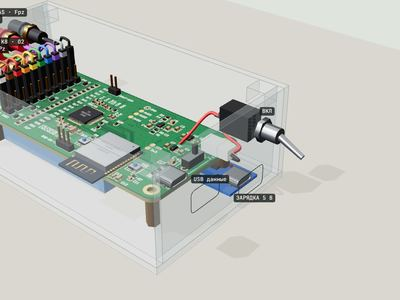
docs/img/steps/p07.jpg
