PaperPit/DIY-EEG-OpenMind/docs/img/steps/p08.jpg

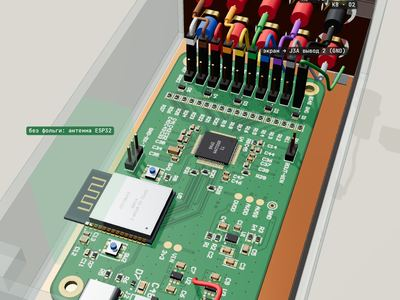
docs/img/steps/p08.jpg
