PaperPit/DIY-EEG-OpenMind/docs/img/steps/p09.jpg

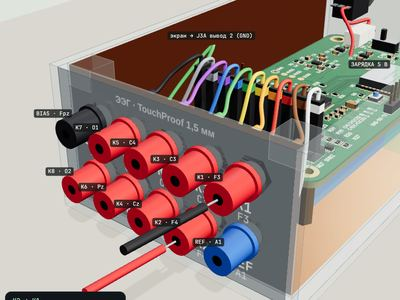
docs/img/steps/p09.jpg
