PaperPit/DIY-EEG-OpenMind/docs/img/steps/p11.jpg

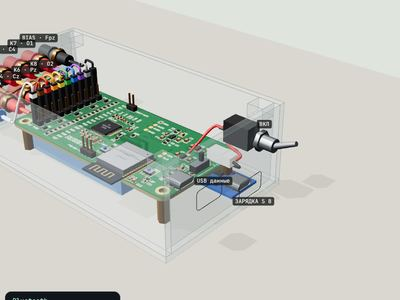
docs/img/steps/p11.jpg
