PaperPit/DIY-EEG-OpenMind/docs/img/steps/p13.jpg

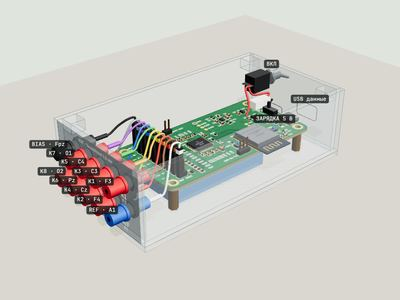
docs/img/steps/p13.jpg
