PaperPit/DIY-EEG-OpenMind/docs/img/steps/s01.jpg

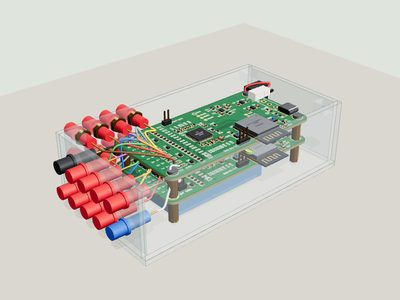
docs/img/steps/s01.jpg
