PaperPit/DIY-EEG-OpenMind/docs/img/steps/s02.jpg

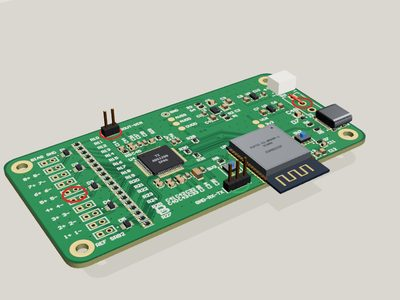
docs/img/steps/s02.jpg
