PaperPit/DIY-EEG-OpenMind/docs/img/steps/s03.jpg

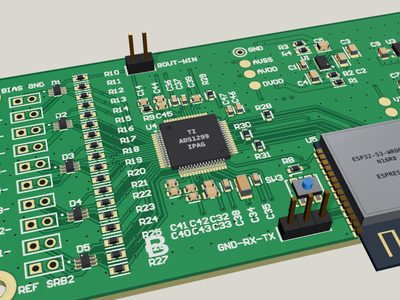
docs/img/steps/s03.jpg
