PaperPit/DIY-EEG-OpenMind/docs/img/steps/s04.jpg

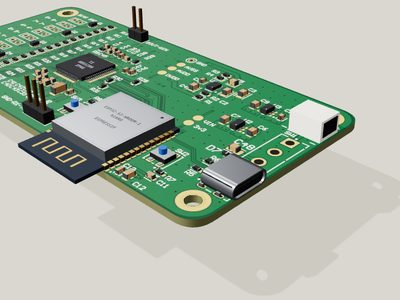
docs/img/steps/s04.jpg
