PaperPit/DIY-EEG-OpenMind/docs/img/steps/s05.jpg

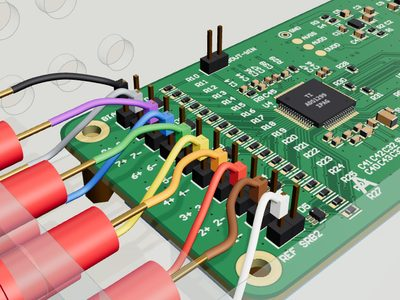
docs/img/steps/s05.jpg
