PaperPit/DIY-EEG-OpenMind/docs/img/steps/s06.jpg

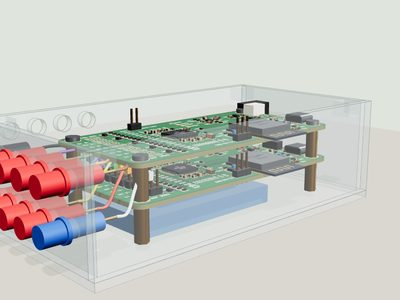
docs/img/steps/s06.jpg
