PaperPit/DIY-EEG-OpenMind/docs/img/steps/s07.jpg

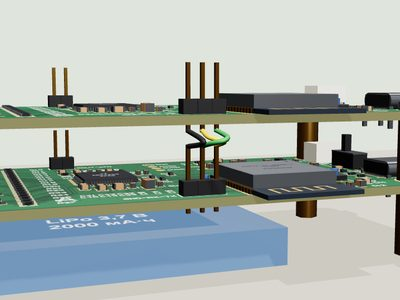
docs/img/steps/s07.jpg
