PaperPit/DIY-EEG-OpenMind/docs/img/steps/s08.jpg

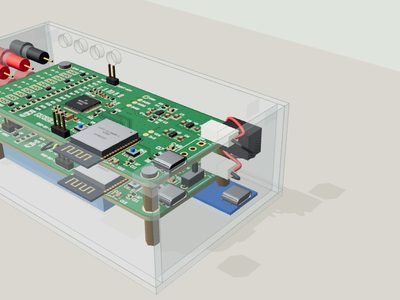
docs/img/steps/s08.jpg
