PaperPit/DIY-EEG-OpenMind/docs/img/steps/s09.jpg

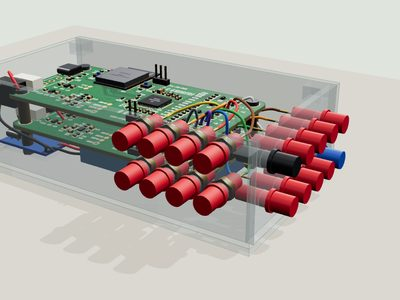
docs/img/steps/s09.jpg
