PaperPit/DIY-EEG-OpenMind/docs/img/steps/s10.jpg

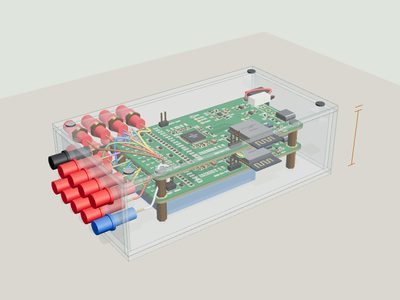
docs/img/steps/s10.jpg
