PaperPit/DIY-EEG-OpenMind/docs/img/steps/s11.jpg

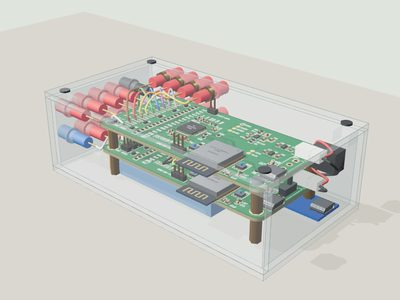
docs/img/steps/s11.jpg
