PaperPit/DIY-EEG-OpenMind/docs/img/steps/s12.jpg

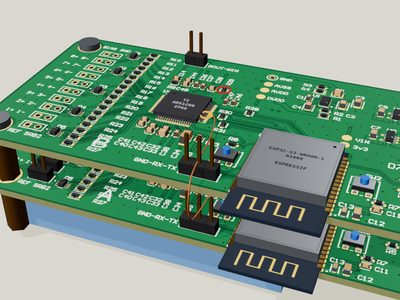
docs/img/steps/s12.jpg
