PaperPit/DIY-EEG-OpenMind/docs/img/steps/t02.jpg

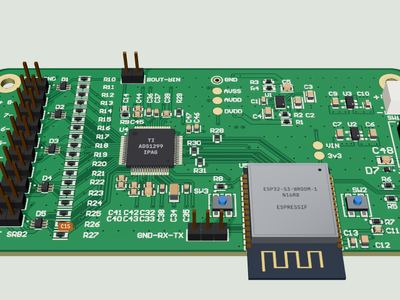
docs/img/steps/t02.jpg
