PaperPit/DIY-EEG-OpenMind/docs/img/steps/t03.jpg

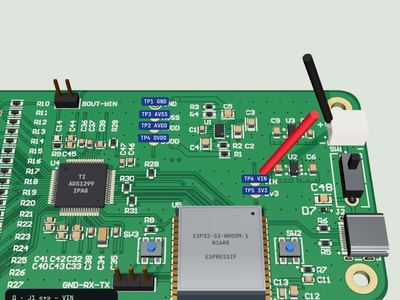
docs/img/steps/t03.jpg
