PaperPit/DIY-EEG-OpenMind/docs/img/steps/t04.jpg

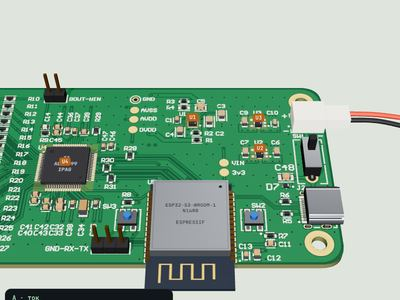
docs/img/steps/t04.jpg
