PaperPit/DIY-EEG-OpenMind/docs/img/steps/t05.jpg

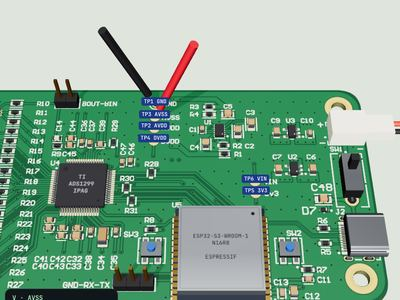
docs/img/steps/t05.jpg
