PaperPit/DIY-EEG-OpenMind/docs/img/steps/t06.jpg

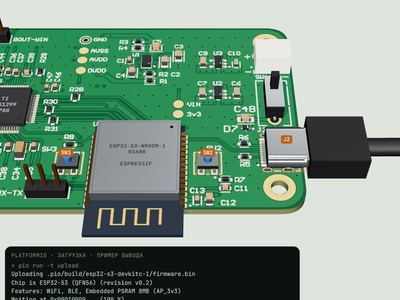
docs/img/steps/t06.jpg
