PaperPit/DIY-EEG-OpenMind/docs/img/steps/t07.jpg

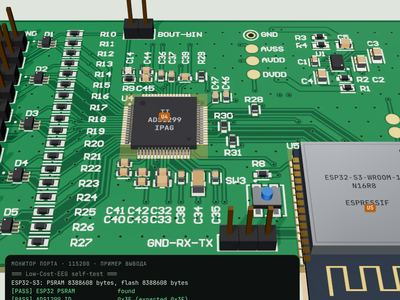
docs/img/steps/t07.jpg
