PaperPit/DIY-EEG-OpenMind/docs/img/steps/t09.jpg

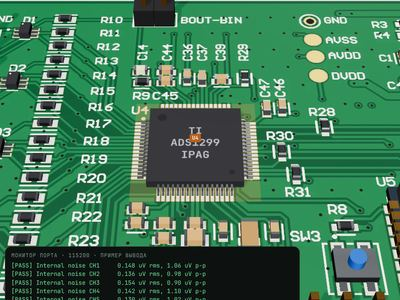
docs/img/steps/t09.jpg
