PaperPit/DIY-EEG-OpenMind/docs/img/steps/t10.jpg

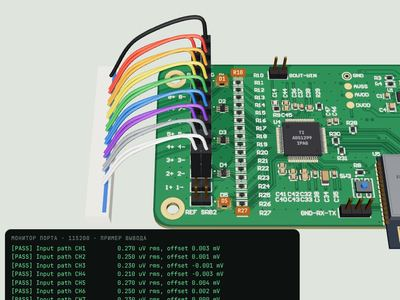
docs/img/steps/t10.jpg
