PaperPit/DIY-EEG-OpenMind/docs/img/steps/t11.jpg

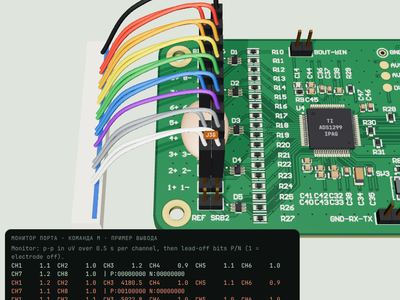
docs/img/steps/t11.jpg
