PaperPit/DIY-EEG-OpenMind/docs/img/steps/t12.jpg

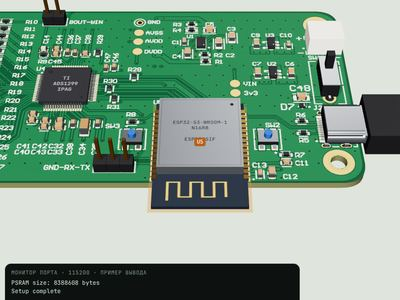
docs/img/steps/t12.jpg
