PaperPit/DIY-EEG-OpenMind/docs/img/steps/t13.jpg

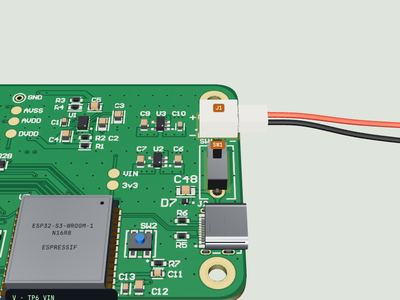
docs/img/steps/t13.jpg
