PaperPit/DIY-EEG-OpenMind/(commit log)

2026-10-26 Народное ЭЭГ: инструкции, плата, корпус, панель электродов, самотест
    Сборка 8-канального ЭЭГ на основе Low-Cost-EEG (Xavier Asghar, GPL v3):
    3D-инструкции по сборке и проверке, Gerber для Резонита и JLCPCB,
    корпус из оргстекла с панелью TouchProof, прошивка самотеста ADS1299.
    Claude-Session: https://claude.ai/code/session_01PQxxJsW7Z2TUaVksyCm1GW
    [bom.csv, case-acrylic-3mm-cut.dxf, shopping-list-panel.csv, shopping-list.csv]
2026-10-26 README: заголовок по названию репозитория
    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
2026-10-26 Визуализации: интерактивная стартовая страница, рендеры прибора, миниатюры шагов
    - docs/index.html: итоговый прибор и характеристики, «что получится»,
    интерактивная схема интерфейса 3D-инструкций, маршрут из 6 этапов
    с миниатюрами всех 43 шагов и прогрессом (читает отметки инструкций)
    - README: рендеры платы, корпуса и панели, схема маршрута, галерея
    процесса, как пользоваться 3D-инструкция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
2026-10-26 Анимация вращения собранного прибора в README и на стартовой странице
    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
2026-10-26 GitHub Pages: корень сайта открывает стартовую страницу инструкций
    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
2026-10-26 README: кнопка «Начните отсюда» со ссылкой на онлайн-инструкции
    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
2026-10-26 Исправить самотест питания и частоты DRDY.
    MUX 011 измеряет (AVDD−AVSS)/4, около 5 В, а не DVDD 3,3 В. Частоту считать по успешным чтениям за секунду: короткий импульс DRDY без чтения выборки легко потерять.
    [main.cpp]
2026-10-26 Сделать самотест готовым проектом PlatformIO под N16R8.
    В репозитории теперь platformio.ini на 16 МБ flash и библиотека ADS1299, так что подменять main.cpp в проекте автора больше не нужно. Сборка pio run проходит.
2026-10-26 Добавить прошивку ЭЭГ и просмотр сигнала в браузере.
    Пакеты Bluetooth укорочены до 112 байт, чтобы их принимал macOS. Страница в Chrome показывает 8 каналов, полосу 1–40 Гц и спектр. Для альфы заданы O1, O2, референс на мочке и BIAS на лбу.
2026-10-26 Указать 100 кОм для входных резисторов R10–R27.
    Во всех инструкциях и списках покупок восемнадцать резисторов 0603 теперь 100 кОм, а не 2,2 кОм автора. Так ток в электрод при пробое 5 В около 50 мкА.
    [bom.csv, shopping-list.csv]
2026-10-26 Показать на главной перечень деталей без цен.
    Для шума и точности указаны конкретные микросхемы и пассивные ряды. У остальной обвязки оставлены номинал, корпус и тип.
2026-10-26 Заменить гифку прибора скриншотом со ссылкой на 3D.
    Из каждой инструкции, чек-листа, просмотра сигнала и обзоров электродов добавлена кнопка возврата в главное меню.
2026-10-26 Перевести запись на 250 Гц и поправить инструкции.
    SW3 снова включает проверку контакта, статус BIAS читает нужный бит, а страница просмотра считает длинные обрывы. В провода электродов добавлен второй резистор 100 кОм.
    [bom.csv, shopping-list.csv]
2026-10-26 Поставить на главную ссылку на гербер платы.
    В архиве остались те же слои и сверловка, имя текстового файла внутри сделано латинским.
2026-10-26 R10–R27 2,2 кОм для минимального шума, исправления MVDD и BIAS_STAT
    - R10–R27 снова 2,2 кОм, как у автора: шум резисторов около 0,05 мкВ rms.
    Резистор 100 кОм в проводе стал необязательной защитой.
    - hardware/INPUT-RESISTORS.md: таблица шума и тока при пробое для трёх
    вариантов, обоснование выбора и требования к питанию.
    - Самотест: в режиме MVDD каналы 3 и 4 измеряют DVDD/4.
    - firmware/eeg: BIAS_STAT это бит 0 CONFIG3.
    - README: TLV75733 совпадает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
    [bom.csv, shopping-list.csv]
2026-10-28 Новая стартовая страница: проще сверху, глубже снизу, RU + EN
    Тёмная тема в духе DIY-лаборатории со светлым вариантом, живая
    симуляция 8 каналов с альфа-ритмом, маршрут сборки с прогрессом,
    подробности в раскрывающихся блоках, переключатель RU/EN.
    Claude-Session: https://claude.ai/code/session_01RBRmFCMqmpquQvWvqH74g6
2026-10-28 Improve search discoverability in Russian and English
    - README: RU/EN keyword lead, English summary, keywords footer
    - README.en.md: full English overview
    - Start page: richer title/description, canonical, hreflang ru/en,
    absolute OpenGraph/Twitter tags, JSON-LD (WebSite + SoftwareSourceCode)
    - All guide pages: descriptive titles, description, canonical, OpenGraph;
    doctype/charset/viewport for pages that lacked them
    - Electrode pages: fix horizontal overflow on phones (grid minmax)
    - sitemap.xml for Google Search Console / Yandex Webmaster
    - docs/img/social-preview.jpg (1280x640) for link previews
    Claude-Session: https://claude.ai/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
2026-10-28 Add 16-channel second-floor guide, two-board firmware and 16-channel viewer
    docs/05-16-channels.html: second Low-Cost-EEG board stacked on M3 standoffs,
    linked to the main board over J5 UART; optional shared ADS1299 clock.
    firmware/eeg16: env board_a (16 ch over BLE, 55-byte samples) and board_b.
    viewer.html detects 28- or 55-byte samples and shows 8 or 16 channels.
    Claude-Session: https://claude.ai/code/session_01RBRmFBnfjrSL5jRDVUCa8m
2026-10-28 Add 3D lesson for the 16-channel second floor and route stage 7
    docs/06-16-channels-3d.html: 12 steps on the part 3 engine (board B,
    standoffs, J5 crossover, power, sockets К9-К16 on wall F, checks,
    optional shared clock), done marks in localStorage eeg-16-done.
    Step thumbnails img/steps/s01-s12, stage 7 on the start page (RU/EN),
    links in READMEs, sitemap and the text guide.
    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
2026-11-10 3D-инструкции: общая three.js, отрисовка по требованию, телефоны, единый тёмный стиль
    - three.js r160 и аддоны вынесены в docs/vendor/three-kit.r160.min.js (один раз на все страницы, кэшируется),
    данные платы и текстуры в docs/assets/board-data.js. Страницы 01/02/04/06 стали ~70–100 КБ вместо 1–1,3 МБ.
    - docs/assets/guide-kit.js: сцена рисуется только когда что-то движется (раньше 60 кадров/с всегда),
    адаптивная плотность пикселей, понятное со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
2026-11-10 Инструкции подробнее: время и сложность шага, частые ошибки, словарь терминов
    - docs/assets/guide-extras.js: для всех 55 шагов четырёх 3D-инструкций время, сложность
    и раскрывающийся блок «Частые ошибки и как исправить».
    - Словарь из 30 терминов (C0G, галтель, надгробие, ракель, флюс, BIAS, SRB1, LiPo, TP4056…):
    термин в тексте подчёркнут, по нажатию или наведению показывается объяснение.
    - 01, шаг 7: теория про ш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
2026-11-10 Сайт и проверки: видимые разделы, свои шрифты везде, автосборка прошивок
    - docs/index.html: разделы больше не прячутся до прокрутки, если скрипт не сработал,
    при печати и для поисковиков; появление срабатывает надёжнее на длинных разделах.
    - Google Fonts убран со всех страниц: чек-лист и страницы про электроды тоже на
    Manrope + JetBrains Mono из docs/vendor/fonts.
    - Драйвер ADS1299 (3 копии): исправлен коэффициент пере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
2026-11-10 Удалить неиспользуемую docs/img/device-rotate.gif (2 МБ)
    Claude-Session: https://claude.ai/code/session_01RBRmF8GhMDricYkuJThfT3
